PetarBarakov/FYP_WirelessSensorNetwork/hardware/FYP_ECG_ACCEL_board/JLC_docs/ECG_ACC_BOM/ECG_ACC_BOM-ECG_ACCEL_Board(V1).xlsx

Name | Designator | Footprint | JLC Part Number
C_0402_0.1uF | C1, C2, C3, C7, C10, C11, C15, C16, C17, C20, C24, C25, C26 | C_0402 | C1525
C_0402_4.7nF | C27, C28, C29, C30 | C_0402 | C1538
C_0402_10nF | C9 | C_0402 | C15195
C_0402_10uF | C6, C14 | C_0402 | C15525
R_0402_51k | R8, R9 | R_0402 | C25794
R_0402_4k7 | R1, R2, R3, R4, R5, R6, R7, R12 | R_0402 | C25900
C_0402_10pF | C4, C5 | C_0402 | C32949
C_0402_1uF | C8, C18, C19, C21, C22, C23, C31, C32 | C_0402 | C52923
L_0402_2.2nH | L1, L2, L3 | L_0402 | C92035
C_0402_3.3pF | C12, C13 | C_0402 | C326841
TLV75533PDBVR | U3 | SOT95P280X145-5N | C404027
40MHz_OSC | X1 | 40MHz_OSC-Footprint-1 | C426988
ADS1292 | U4 | QFN127P600-8N | C456281
ESP32-C3 | U1 | QFN127P600-8N | C2858491
