PetarBarakov/FYP_WirelessSensorNetwork/hardware/FYP_PPG_board/JLC_docs/PPG_BOM/PPG_BOM-PPG_Board(V1).xlsx

Name | Designator | Footprint | JLC Part Number
C_0402_0.1uF | C1, C2, C3, C7, C10, C11 | C_0402 | C1525
C_0402_10nF | C9 | C_0402 | C15195
C_0402_10uF | C6, C15, C21 | C_0402 | C15525
C_0402_4.7uF | C22 | C_0402 | C23733
R_0402_4k7 | R1, R2, R3, R4, R5, R6, R7 | R_0402 | C25900
C_0402_10pF | C4, C5 | C_0402 | C32949
C_0402_1uF | C8, C14, C18, C19 | C_0402 | C52923
L_0402_2.2nH | L1, L2 | L_0402 | C92035
R_0402_300k | R8 | R_0402 | C100363
C_0402_3.3pF | C12, C13 | C_0402 | C326841
C_0402_150pF | C20 | C_0402 | C363531
TLV75533PDBVR | U3 | SOT95P280X145-5N | C404027
40MHz_OSC | X1 | 40MHz_OSC-Footprint-1 | C426988
R_0402_240k | R9 | R_0402 | C429390
ESP32-C3 | U1 | QFN127P600-8N | C2858491
XCL206F083 | U5 | XCL206F083-Footprint-1 | C2891283
MAX30102 | U2 | MAX30102-Footprint-1 | C6454833
