PetarBarakov/FYP_WirelessSensorNetwork/hardware/FYP_TH_board/JLC_docs/BOM/Bill of Materials-TH_Board(V1).xlsx

Name | Designator | Footprint | JLC Part Number
2.4GHZ_ANT_50_OHM | ANT1 | Chip2PinSM127P600-8N
C_0402_0.1uF | C1, C2, C3, C7, C10, C11, C14 | C_0402 | C1525
C_0402_10nF | C9 | C_0402 | C15195
C_0402_10uF | C6 | C_0402 | C15525
R_0402_4k7 | R1, R2, R3, R4, R5, R6 | R_0402 | C25900
C_0402_10pF | C4, C5 | C_0402 | C32949
C_0402_1uF | C8, C18, C19 | C_0402 | C52923
L_0402_2.2nH | L1, L2 | L_0402 | C92035
C_0402_3.3pF | C12, C13 | C_0402 | C326841
TLV75533PDBVR | U3 | SOT95P280X145-5N | C404027
40MHz_OSC | X1 | 40MHz_OSC-Footprint-1 | C426988
ESP32-C3 | U1 | QFN127P600-8N | C2858491
SHT40_B | U2 | SHT40_B-Footprint-1 | C3664342
