PetarBarakov/FYP_WirelessSensorNetwork/(list of files, drawings)

Other design files:
hardware/FYP_ECG_ACCEL_board/ECG_ACCEL_Board.PcbDoc
hardware/FYP_ECG_ACCEL_board/ECG_ACCEL_Board.SchDoc
hardware/FYP_ECG_ACCEL_board/ECG_Schematic.SchDoc
hardware/FYP_ECG_ACCEL_board/FYP_ECG_ACCEL_board.PrjPcb
hardware/FYP_ECG_ACCEL_board/MCU_power.SchDoc
hardware/FYP_PPG_board/FYP_PPG_board.PrjPcb
hardware/FYP_PPG_board/MCU_power.SchDoc
hardware/FYP_PPG_board/PPG_Board.PcbDoc
hardware/FYP_PPG_board/PPG_Board.SchDoc
hardware/FYP_Protoboard1/FYP_Protoboard1.PrjPcb
hardware/FYP_Protoboard1/MCU_main.SchDoc
hardware/FYP_Protoboard1/MCU_power.SchDoc
hardware/FYP_Protoboard1/PowerSupply.SchDoc
hardware/FYP_Protoboard1/Sensors.SchDoc
hardware/FYP_Protoboard1/Sensors_Power_Characterisation_Board.SchDoc
hardware/FYP_TH_board/FYP_TH_board.PrjPcb
hardware/FYP_TH_board/MCU_power.SchDoc
hardware/FYP_TH_board/TH_Board.PcbDoc
hardware/FYP_TH_board/TH_Board.SchDoc
hardware/FYP_VOC_board/FYP_VOC_board.PrjPcb
hardware/FYP_VOC_board/MCU_power.SchDoc
hardware/FYP_VOC_board/VOC_Board.PcbDoc
hardware/FYP_VOC_board/VOC_Board.SchDoc
hardware/USB_C_programmer_board/USB_C_programmer_1.SchDoc
hardware/USB_C_programmer_board/USB_C_programmer_board.PcbDoc
hardware/USB_C_programmer_board/USB_C_programmer_board.PrjPcb
