PetarBarakov/FYP_WirelessSensorNetwork/software/SerialDataPlottingTool/SerialData/power_measurements_ble_disabled.csv

Program Time [s] | data 0 | data 1 | data 2 | data 3 | data 4 | data 5 | data 6 | data 7
2545.51 | 35.7308 | 3.6848 | 5.47813 | 3.30039 | 12.9506 | 3.29844 | 0.275 | 1.8
2545.52 | 36.2115 | 3.68 | 5.51641 | 3.29766 | 7.93264 | 3.30059 | 0.275 | 1.7984
2545.54 | 34.3077 | 3.6816 | 5.13438 | 3.30019 | 20.5712 | 3.29922 | 0.270833 | 1.7984
2545.55 | 34.5 | 3.68 | 5.51875 | 3.29785 | 28.2543 | 3.29688 | 0.266667 | 1.7984
2545.57 | 36.4423 | 3.6832 | 5.50859 | 3.29805 | 19.0068 | 3.2998 | 0.279167 | 1.8
2545.58 | 35.6731 | 3.6832 | 5.56953 | 3.29941 | 14.5231 | 3.29844 | 0.279167 | 1.7984
2545.6 | 28.75 | 3.68 | 5.55469 | 3.29707 | 18.9684 | 3.29785 | 0.275 | 1.7984
2545.61 | 34.8654 | 3.6816 | 5.56484 | 3.29785 | 27.6354 | 3.29902 | 0.270833 | 1.7984
2545.63 | 37.1346 | 3.6848 | 5.51328 | 3.29883 | 22.8263 | 3.2998 | 0.275 | 1.8
2545.64 | 35.5577 | 3.6816 | 5.55547 | 3.29785 | 20.3154 | 3.29629 | 0.279167 | 1.8
2545.66 | 28.7885 | 3.68 | 5.24453 | 3.29648 | 13.3268 | 3.29707 | 0.2875 | 1.8
2545.67 | 34.6923 | 3.6816 | 5.48672 | 3.29785 | 25.5276 | 3.29824 | 0.279167 | 1.7984
2545.69 | 37.5385 | 3.6832 | 5.55625 | 3.29922 | 22.5267 | 3.29707 | 0.270833 | 1.8
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
