PetarBarakov/FYP_WirelessSensorNetwork/software/SerialDataPlottingTool/SerialData/power_measurements_ble_en.csv

Program Time [s] | data 0 | data 1 | data 2 | data 3 | data 4 | data 5 | data 6 | data 7
2203.85 | 93.1923 | 3.6608 | 21.1398 | 3.29512 | 16.8498 | 3.29512 | 0.275 | 1.7984
2203.86 | 99.0385 | 3.6624 | 21.1422 | 3.2957 | 26.9108 | 3.29238 | 0.270833 | 1.8
2203.88 | 102.635 | 3.6656 | 21.0906 | 3.29492 | 22.769 | 3.29492 | 0.275 | 1.8016
2203.89 | 98.0769 | 3.6624 | 21.2359 | 3.29356 | 7.14633 | 3.29356 | 0.275 | 1.7984
2203.91 | 92.0385 | 3.6608 | 21.1461 | 3.29512 | 11.692 | 3.29434 | 0.279167 | 1.7984
2203.92 | 100.231 | 3.6624 | 21.0766 | 3.29551 | 24.4428 | 3.29512 | 0.279167 | 1.7984
2203.94 | 101.269 | 3.6624 | 21.132 | 3.29473 | 22.4721 | 3.29395 | 0.270833 | 1.7968
2203.95 | 97.7115 | 3.6624 | 21.0844 | 3.29609 | 3.99545 | 3.29473 | 0.275 | 1.8
2203.97 | 93.1538 | 3.6592 | 21.9586 | 3.29531 | 6.63075 | 3.29375 | 0.279167 | 1.7984
2203.98 | 97.3269 | 3.6624 | 21.1141 | 3.2959 | 20.875 | 3.29277 | 0.279167 | 1.8
2204 | 100.827 | 3.664 | 21.0836 | 3.2916 | 22.7662 | 3.29531 | 0.275 | 1.7984
2204.01 | 97.9231 | 3.6624 | 21.0844 | 3.29531 | 5.06139 | 3.29414 | 0.266667 | 1.8
2204.03 | 94.1538 | 3.6544 | 21.9773 | 3.29492 | 3.80537 | 3.29531 | 0.270833 | 1.8
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
