PetarBarakov/FYP_WirelessSensorNetwork/software/SerialDataPlottingTool/SerialData/power_measurements_ble_en_notify.csv

Program Time [s] | data 0 | data 1 | data 2 | data 3 | data 4 | data 5 | data 6 | data 7
111.981 | 114.808 | 3.6624 | 27.3937 | 3.29492 | 22.7722 | 3.29336 | 0.2875 | 1.7984
111.996 | 98.3077 | 3.6624 | 21.2437 | 3.29375 | 7.58896 | 3.29356 | 0.283333 | 1.7984
112.011 | 98.3654 | 3.6624 | 21.8312 | 3.29531 | 21.3907 | 3.2957 | 0.275 | 1.7984
112.026 | 96.0962 | 3.6608 | 31.0039 | 3.29609 | 24.4625 | 3.29375 | 0.275 | 1.8
112.041 | 98.5385 | 3.6608 | 21.8766 | 3.29629 | 22.4464 | 3.29356 | 0.283333 | 1.8
112.056 | 97.6923 | 3.6624 | 21.4977 | 3.29316 | 4.0932 | 3.29434 | 0.283333 | 1.7984
112.071 | 97.9231 | 3.6576 | 22.2859 | 3.29356 | 20.8893 | 3.29258 | 0.275 | 1.8016
112.086 | 94.7308 | 3.6608 | 21.225 | 3.29297 | 21.0774 | 3.29336 | 0.283333 | 1.8016
112.101 | 95.2115 | 3.6608 | 21.143 | 3.29395 | 22.6972 | 3.29512 | 0.283333 | 1.7984
112.116 | 103.077 | 3.664 | 21.4953 | 3.29512 | 4.79512 | 3.29297 | 0.283333 | 1.7984
112.131 | 98 | 3.664 | 21.1227 | 3.29336 | 20.7573 | 3.29356 | 0.275 | 1.8016
112.146 | 95.6538 | 3.6592 | 22.1711 | 3.29492 | 20.8885 | 3.29414 | 0.279167 | 1.8
112.161 | 105.615 | 3.656 | 27.5641 | 3.29512 | 23.4748 | 3.29512 | 0.270833 | 1.7984
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
