PetarBarakov/FYP_WirelessSensorNetwork/firmware/include/header.h

// Standard Arduino Libraries
#include <Arduino.h>
#include <Wire.h>
#include <SPI.h>

//General Communication Libraries
#include "I2C_test.h"
#include "BLE_publish.h"

//Sensor Libraries
#include "SensorClass.h"
#include "SHT40.h"
#include "MAX30102.h"
#include "SGP41.h"
#include "LIS2DE12.h"
#include "ADS1292.h"

//Power Sensor Libraries
#include "INA236.h"
#include "INA228.h"
