PetarBarakov/FYP_WirelessSensorNetwork/(commit log)

2024-03-22 initialise git. Test board for LED blinks and I2C scan
2024-03-29 initialise platform io project. Serial Monitor NOT working
    [main.cpp]
2024-04-12 Add new PlatformIo model of the board with working Serial Monitor
2024-04-15 Transer the I2C test code into separate files to be used if necessary later
2024-04-15 Remove arduino directory from the main branch
2024-04-15 Move the platformio files in the current directory
2024-04-17 Create a Sensor class for the I2C sensors to be used as base for all three sensors. Write the library for the SHT40 sensor, taking temperature and humidity measurements
2024-04-17 Small comment changes to the I2C search library
2024-04-18 Add configiration for the LED and Sp02. All configurations are now set. Successfull compiling of the MAX30102 library
2024-04-18 Read Sp02 fifo single sample
2024-04-19 Firs attempt to read data out of the PPG. ISsue where setting the mode erases set up data
    [main.cpp]
2024-04-23 Small rearanges to the ReadSpO2 function. FIGO still not working at desired sppeds
    [main.cpp]
2024-04-24 Add an init function to the MAX30102 class to ensure that the status registers are changed as they should. Ensure that the fifo saves multiple samples. Error in some readings with more than 32 samopl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
    [main.cpp]
2024-04-25 Fix an error in SpO2 register writing, caused by corelation between the sample rate and the pulse width
    [main.cpp]
2024-04-26 Fix crashing due to more than 32 samples in the fifo
    [main.cpp]
2024-04-26 Initialise power measurement branch
2024-04-26 add function skeleton for the INA236 sensor
2024-05-02 write INA236 drivers, all functions. UNTESTED
2024-05-06 Rename power main file
2024-05-06 Revert to "PPG sampling correctly", keep main_sensor file
    This reverts commit ca81618b4c35c6ddff47f7f2622fc3f85d87560f.
    [main.cpp]
2024-05-06 Unite the power and sensor mains in a single file. The ESP32 target is set through a vairable in the .init file
2024-05-06 Add accelerometer registers definitions
2024-05-08 Initial ECG programming attempts. Sensor is not responding at all
2024-05-09 Unsuccessfull SPI communication attempts
2024-05-11 Two methods of live data plotting. Pre-integration of bluetooth with the animated method of data plotting
    [output.csv, output1.csv]
2024-05-11 Power up test for accelerometer. Accelerometer not responding
2024-05-11 Two thread BLE receiver
2024-05-14 update gitignore
    [output.csv]
2024-05-14 remove data folder
    [output1.csv]
2024-05-15 Calibrated PPG
2024-05-20 INA228 debugging (not working)
    [main.cpp]
2024-05-21 establish correct SPI communication
    [main.cpp]
2024-05-22 Accelerometer tests
2024-05-23 Additionalt accelerometer tests, still not working
    [main.cpp]
2024-05-23 ECG raw data reading working. Soem unconcistancies are still measured, due to the connections of the electrodes to the board and to the skin
2024-05-31 add sampling for the temperature reading
2024-06-02 Working ecg filtering, semi-reliable heart rate, the scale of the values is wrong
    [main.cpp]
2024-06-05 VOC raw data looks fine, conversion does not work and just prints 0-s
    [main.cpp]
2024-06-05 Semiworking accelerometer
2024-06-05 Working accelerometer movement detection, threshold coefficient of 1
2024-06-06 Remove Sensirion Algorithm. Add threshold based comparison of the average NOX and VOC reading. Sensor now working
2024-06-06 commit pre-branch for testing the timers
2024-06-07 Working two-device readouts. Timing is slightly off. No data recording
2024-06-07 ECG accelerometer firmware working
2024-06-07 issue sampling the ECG and accelerometer
2024-06-08 Changes liveplot of temperature and humidity
2024-06-08 Plot all sensors
2024-06-08 fix accelerometer power on issues
    [main.cpp]
2024-06-11 final testign of the sensors
2024-06-12 init power measurement branch
2024-06-13 working current sense amplifiers
2024-06-13 Working Power Measurements
2024-06-14 Add Altium files
    [acc_data1.csv, acc_data1_selected.csv, ecg_data1.csv, ecg_data2.csv, ecg_data2_selected.csv, power_measurements_ble_disabled.csv, power_measurements_ble_en.csv, power_measurements_ble_en_notify.csv]
2024-06-14 Re-add all hardware files
    [Bill of Materials-TH_Board(V1).xlsx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]
2024-06-14 fast BLE power sampling
